daharoni/Miniscope_CMOS_Imaging_Sensor_PCB/v3_2/Assembly Files/CMOSv3_2_BOM.xlsx

Value | Comment | Digikey Part Number | Manufacturer Part Number | Designator | Footprint | LibRef | Quantity
Capacitors
10uF | CAP CER 10UF 16V 20% X5R 0603 | 490-7201-1-ND (http://www.digikey.com/product-detail/en/GRM188R61C106MA73D/490-7201-1-ND/3900482) | GRM188R61C106MA73D (http://www.digikey.com/product-detail/en/GRM188R61C106MA73D/490-7201-1-ND/3900482) | C1 | SMD Capacitor 0603 | Capacitor | 1
22uF | CAP CER 22UF 6.3V 20% X5R 0603 | 490-7611-1-ND (http://www.digikey.com/product-detail/en/GRM188R60J226MEA0D/490-7611-1-ND/4280544) | GRM188R60J226MEA0D (http://www.digikey.com/product-detail/en/GRM188R60J226MEA0D/490-7611-1-ND/4280544) | C2, C17 | SMD Capacitor 0603 | Capacitor | 2
2.2uF | CAP CER 2.2UF 10V X5R 0402 | 490-10451-1-ND | GRM155R61A225KE95D | C3 | SMD CAP 0402 | Capacitor | 1
4.7uF | CAP CER 4.7UF 6.3V X5R 0402 | 490-5915-1-ND | GRM155R60J475ME47D | C4, C9, C12, C20 C27, C29 | SMD CAP 0402 | Capacitor | 6
0.1uF | CAP CER 0.1UF 16V 10% X7R 0402 | 490-3261-1-ND (http://www.digikey.com/product-detail/en/GRM155R71C104KA88D/490-3261-1-ND/702802) | GRM155R71C104KA88D (http://www.digikey.com/product-detail/en/GRM155R71C104KA88D/490-3261-2-ND/675947) | C5, C7, C10, C13, C15, C18, C22, C23, C25, C26, C28, C30, C32 | SMD CAP 0402 | Capacitor | 13
0.01uF | CAP CER 10000PF 50V X7R 0402 | 490-4516-1-ND (http://www.digikey.com/product-detail/en/GRM155R71H103KA88D/490-4516-1-ND/1033275) | GRM155R71H103KA88D (http://www.digikey.com/product-detail/en/GRM155R71H103KA88D/490-4516-1-ND/1033275) | C6, C8, C11, C14, C16, C31 | SMD CAP 0402 | Capacitor | 6
0.047uF | CAP CER 0.047UF 25V 10% X7R 0402 | 490-3254-1-ND (http://www.digikey.com/product-detail/en/GRM155R71E473KA88D/490-3254-1-ND/702795) | GRM155R71E473KA88D (http://www.digikey.com/product-detail/en/GRM155R71E473KA88D/490-3254-1-ND/702795) | C19 | SMD CAP 0402 | Capacitor | 1
4.7uF | CAP CER 4.7UF 16V 10% X5R 0603 | 490-10730-1-ND (http://www.digikey.com/product-detail/en/GRM188R61C475KE11D/490-10730-1-ND/5251370) | GRM188R61C475KE11D (http://www.digikey.com/product-detail/en/GRM188R61C475KE11D/490-10730-1-ND/5251370) | C21 | SMD Capacitor 0603 | Capacitor | 1
1uF | CAP CER 1UF 6.3V X5R 0402 | 490-1320-1-ND (http://www.digikey.com/product-detail/en/GRM155R60J105KE19D/490-1320-1-ND/587919) | GRM155R60J105KE19D (http://www.digikey.com/product-detail/en/GRM155R60J105KE19D/490-1320-1-ND/587919) | C24 | SMD CAP 0402 | Capacitor | 1
Inductors
Ferrite Bead | FIXED IND 2.2UH 600MA 340 MOHM | 490-4994-1-ND (http://www.digikey.com/product-detail/en/LQM21PN2R2MC0D/490-4994-1-ND/1788292) | LQM21PN2R2MC0D (http://www.digikey.com/product-detail/en/LQM21PN2R2MC0D/490-4994-1-ND/1788292) | L1, L2 | LQM21PN2R2MC0D | Ferrite Bead | 2
Ferrite Bead | FERRITE CHIP 600 OHM 1300MA 0603 | 490-5258-1-ND (http://www.digikey.com/product-detail/en/BLM18KG601SN1D/490-5258-1-ND/1982781) | BLM18KG601SN1D (http://www.digikey.com/product-detail/en/BLM18KG601SN1D/490-5258-1-ND/1982781) | L3, L4, L5 | BLM18KG601SN1D | Ferrite Bead | 3
Ferrite Bead | FIXED IND 4.7UH 750MA 260 MOHM | 1276-6204-1-ND (http://www.digikey.com/product-detail/en/CIG21L4R7MNE/1276-6204-1-ND/3972122) | CIG21L4R7MNE (http://www.digikey.com/product-detail/en/CIG21L4R7MNE/1276-6204-1-ND/3972122) | L6 | CIG21L4R7MNE | Ferrite Bead | 1
Ferrite Bead | FIXED IND 100UH 340MA 1.82 OHM | 587-1628-1-ND (http://www.digikey.com/product-detail/en/CBC3225T101MR/587-1628-1-ND/1008243) | CBC3225T101MR (http://www.digikey.com/product-detail/en/CBC3225T101MR/587-1628-1-ND/1008243) | L7 | CBC3225T101MR | Ferrite Bead | 1
Resistors
500 | RES SMD 499 OHM 1% 1/16W 0402 | 311-499LRCT-ND (http://www.digikey.com/product-detail/en/RC0402FR-07499RL/311-499LRCT-ND/729570) | RC0402FR-07499RL | R1 | SMD RES 0402 | Resistor | 1
100k | RES SMD 100K OHM 1% 1/16W 0402 | 311-100KLRCT-ND (http://www.digikey.com/product-detail/en/RC0402FR-07100KL/311-100KLRCT-ND/729473) | RC0402FR-07100KL (http://www.digikey.com/product-detail/en/RC0402FR-07100KL/311-100KLRCT-ND/729473) | R2, R6 | SMD RES 0402 | Resistor | 2
49.9 | RES SMD 49.9 OHM 1% 1/16W 0402 | 311-49.9LRCT-ND (http://www.digikey.com/product-detail/en/RC0402FR-0749R9L/311-49.9LRCT-ND/729568) | RC0402FR-0749R9L (http://www.digikey.com/product-detail/en/RC0402FR-0749R9L/311-49.9LRCT-ND/729568) | R3 | SMD RES 0402 | Resistor | 1
10k | RES SMD 10K OHM 1% 1/16W 0402 | 311-10.0KLRCT-ND (http://www.digikey.com/product-detail/en/RC0402FR-0710KL/311-10.0KLRCT-ND/729470) | RC0402FR-0710KL (http://www.digikey.com/product-detail/en/RC0402FR-0710KL/311-10.0KLRCT-ND/729470) | R4, R5, R14 | SMD RES 0402 | Resistor | 3
3.3k | RES SMD 3.3K OHM 1% 1/16W 0402 | 311-3.30KLRCT-ND (http://www.digikey.com/product-detail/en/RC0402FR-073K3L/311-3.30KLRCT-ND/729527) | RC0402FR-073K3L (http://www.digikey.com/product-detail/en/RC0402FR-073K3L/311-3.30KLRCT-ND/729527) | R7, R8 | SMD RES 0402 | Resistor | 2
1k | RES SMD 1K OHM 1% 1/16W 0402 | 311-1.00KLRCT-ND (http://www.digikey.com/product-detail/en/RC0402FR-071KL/311-1.00KLRCT-ND/729460) | RC0402FR-071KL (http://www.digikey.com/product-detail/en/RC0402FR-071KL/311-1.00KLRCT-ND/729460) | R9, R10, R11 | SMD RES 0402 | Resistor | 3
10 | RES SMD 10 OHM 1% 1/10W 0402 | p10.0lct-nd | erj-2rkf10r0x | R12 | SMD RES 0402 | Resistor | 1
1.25k | RES SMD 1.24K OHM 1% 1/16W 0402 | 311-1.24KLRCT-ND (http://www.digikey.com/product-detail/en/RC0402FR-071K24L/311-1.24KLRCT-ND/2827932) | RC0402FR-071K24L (http://www.digikey.com/product-detail/en/RC0402FR-071K24L/311-1.24KLRCT-ND/2827932) | R13 | SMD RES 0402 | Resistor | 1
ICs
OSC_26MHz_EPSON | OSC XO 26.000MHZ CMOS SMD | SER3701CT-ND (http://www.digikey.com/product-detail/en/SG-211SCE%2026.0000MT3/SER3701CT-ND/2403474) | SG-211SCE 26.0000MT3 | u6 | OSC SG_211SCE 26MHz | OSC_26MHz_EPSON | 1
TPS62172DSGT | IC REG BUCK 3.3V 0.5A SYNC 8WSON | 296-29879-1-ND (http://www.digikey.com/product-detail/en/TPS62172DSGT/296-29879-1-ND/2781002) | TPS62172DSGT (http://www.digikey.com/product-detail/en/TPS62172DSGT/296-29879-1-ND/2781002) | U1 | DSG8-1600X900TP | TPS62172DSGT | 1
TPS62231DRYT | IC REG BUCK 1.8V 0.5A SYNC 6SON | 296-24485-1-ND (http://www.digikey.com/product-detail/en/TPS62231DRYT/296-24485-1-ND/2057751) | TPS62231DRYT (http://www.digikey.com/product-detail/en/TPS62231DRYT/296-24485-1-ND/2057751) | U2 | DRY6 | TPS62231DRYT | 1
DS90UB913A | IC SER/DES 10-100MHZ FPD 32WQFN | 296-37226-1-ND (http://www.digikey.com/scripts/DkSearch/dksus.dll?Detail&itemSeq=181269562&uq=635797476610395265) | DS90UB913ATRTVTQ1 | U3 | WQFN32 for DS90UB913A | DS90UR913A | 1
LT3092EDD#PBF | IC CURRENT SOURCE 1% 8DFN | LT3092EDD#PBF-ND | LT3092EDD#PBF | U4 | LT-DD-8_V | LT3092EDD#PBF | 1
DAC5571IDBVR | 8 BIT 12C SNGL CHNL DAC SOT23-6 | 296-38918-1-ND (http://www.digikey.com/product-detail/en/DAC5571IDBVR/296-38918-1-ND/5143024) | DAC5571IDBVR (http://www.digikey.com/product-detail/en/DAC5571IDBVR/296-38918-1-ND/5143024) | U5 | TI-DBV6_M | DAC5571IDBVR | 1
LED 0603 | LED RED CLEAR 0603 SMD | 160-1447-1-ND | LTST-C191KRKT | D1 | LED_0603 | LED 0603 | 1
MT9V032C12STM | 1/3-Inch Wide-VGA CMOS Digital Image Sensor |  | MT9V032C12STM | S1 | LCC, 48-Pins | CMOS Sensor | 1
