daharoni/Miniscope_CMOS_Imaging_Sensor_PCB/v3_2/Assembly Files/sensor-pcb-components.png

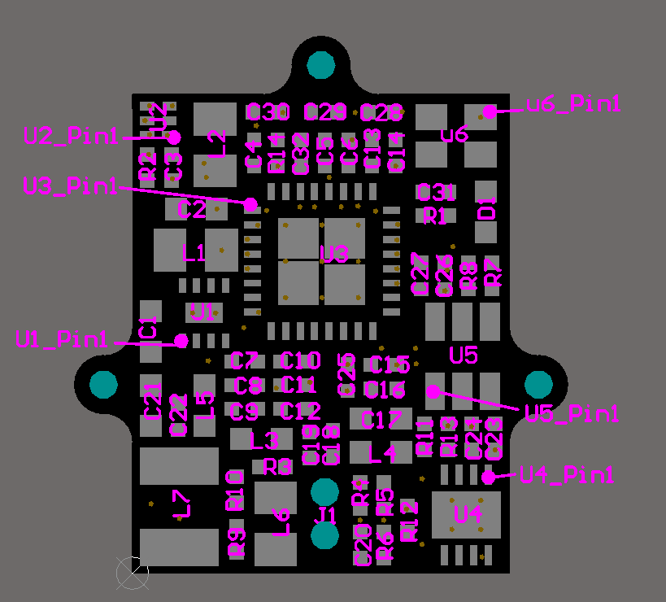
v3_2/Assembly Files/sensor-pcb-components.png
