daharoni/Miniscope_CMOS_Imaging_Sensor_PCB/v3_2/Assembly Files/CMOSv3_2_PCB_Assy_Info.docx

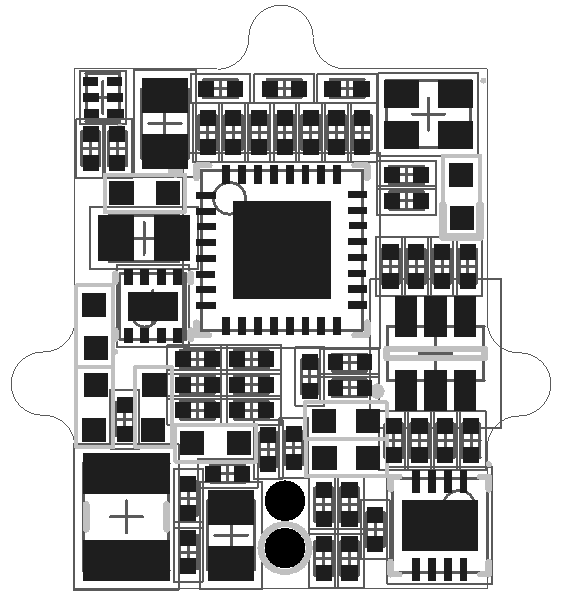
[picture p2: figure]

CMOS Imaging Sensor Circuit Board Assembly Information

- Top layer component descriptors: Mechanical layer 5
- Bottom layer component descriptors: Mechanical layer 6
- Double sided assembly: Yes
- Pin 1 identifiers on Mechanical Layers 5 (GM5) and 6 (GM6)
  - Top: GM5
  - Bottom: GM6

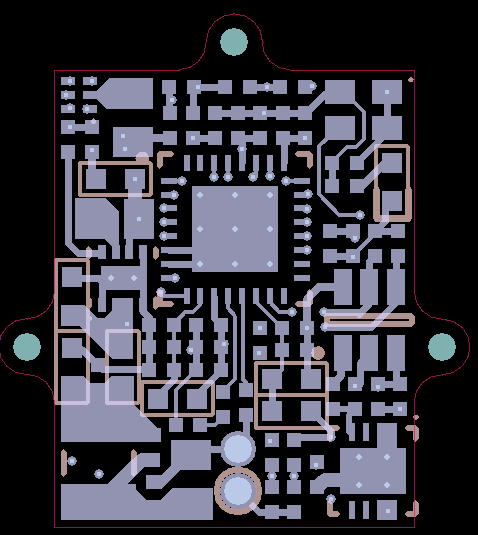
[picture p3: figure]

- D1 (LED) orientation shown below

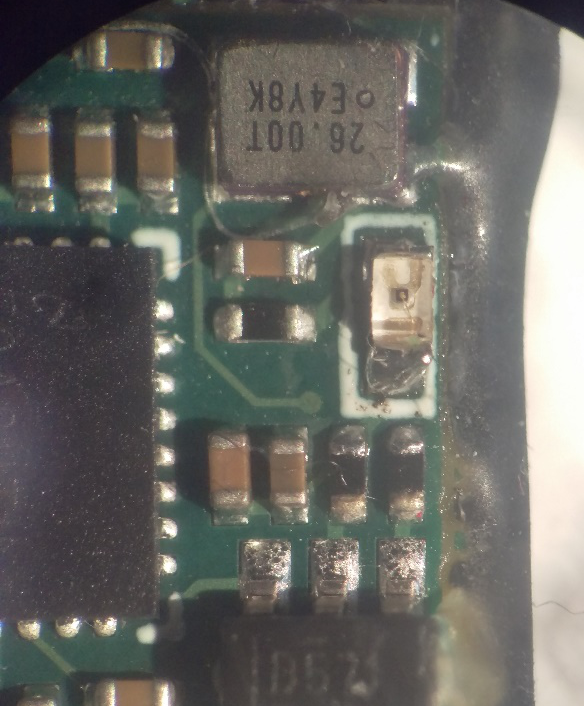
[picture p4: figure]
