daharoni/Miniscope_CMOS_Imaging_Sensor_PCB/v3_0/Assembly Files/CMOS_Imaging_Sensor_PCB_Assy_Info.docx

CMOS Imaging Sensor Circuit Board Assembly Information

- Top layer component descriptors: Mechanical layer 5
- Bottom layer component descriptors: Mechanical layer 6
- Double sided assembly: Yes

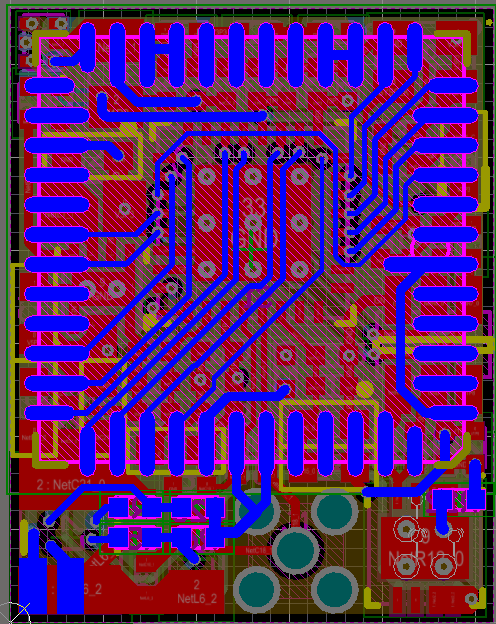
[picture p14: figure]
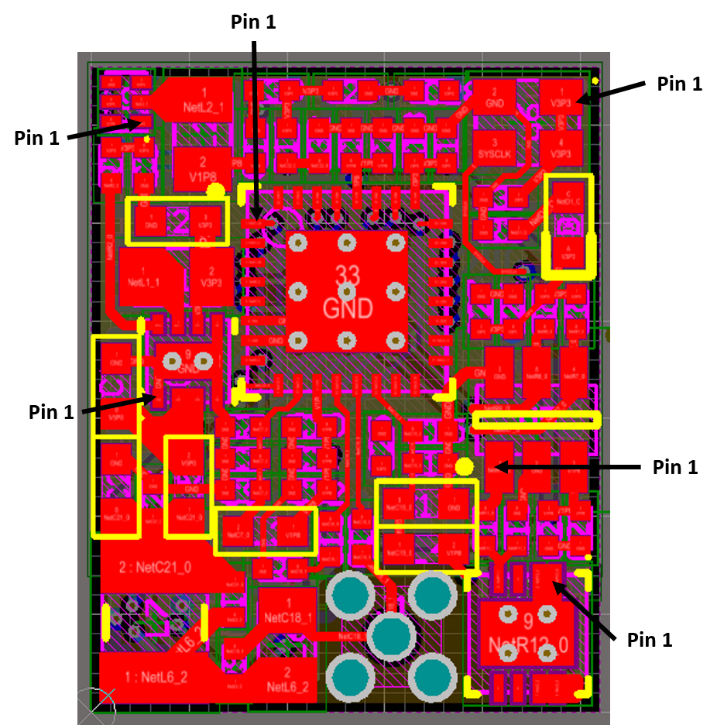
[picture p15: figure]

- Pin 1 identifiers shown below

Pin 1 of S1

- D1 (LED) orientation shown below

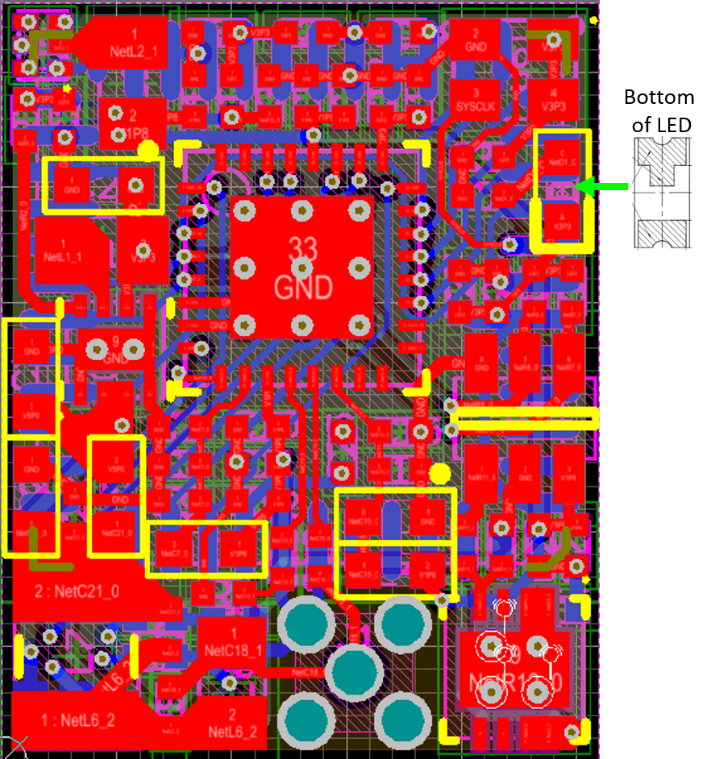
[picture p16: figure]
