daharoni/Miniscope_CMOS_Imaging_Sensor_PCB/(threads)

Thread 1 (2016-04-26):

Put PDFs of schematics and board layouts somewhere in repo

jonnew, 2016-04-26:
Its very hard for the majority of people to manipulate Altium files because they are an extremely closed company -- even the viewer requires account access etc. Altium has great capabilities for outputting schematics and images of board layout as PDFs. I suggest that these be added to repos that have PCB design docs like these.

Gerbers are a good start, but some people won't even know what those are or how to view them. Standard PDFs, preferably right at the top of the file PCB file structure would be great.

jonnew, 2016-04-26:
And, I'm crazy! Its in the top to of the file structure just like I wanted....

Closed 2016-04-26.

Thread 2 (2016-10-28):

Board thickness specification

jonnew, 2016-10-28:
Does the image sensor PCB have to be a particular thickness? I could not find this spec on the .docx file with assembly info.

daharoni, 2016-10-28:
The recommended thickness is in the fabrication CMOSv3_2_PCB_Fab_Info.docx and is 0.031" (half the thickness of standard PCBs). There is no strict requirement on the thickness of this PCB but the thinner the PCB the lighter the entire system will be. I think 0.031" is a good balance between weight, rigidness, and ease of finding a fabrication house that can make it.

jonnew, 2016-10-28:
Great! 0.8mm it is.

Closed 2016-10-28.
