daharoni/Miniscope_CMOS_Imaging_Sensor_PCB/v3_0/CMOS_Imaging_Sensor_PCB_Schematics_Layout.PDF

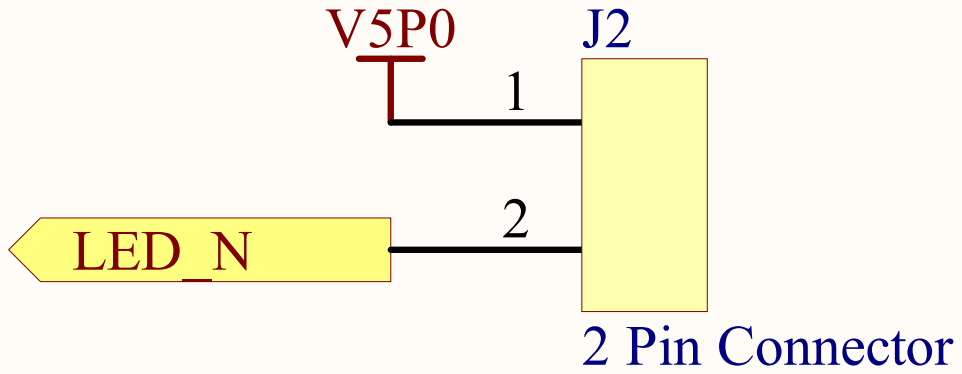
[picture p25: page 1]

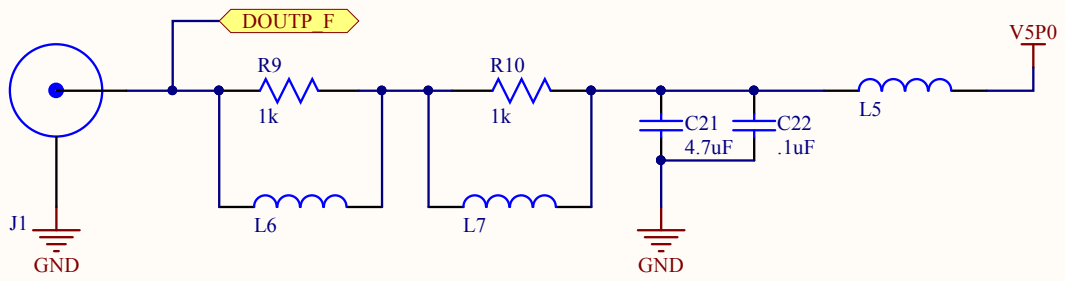
[picture p26: page 2]

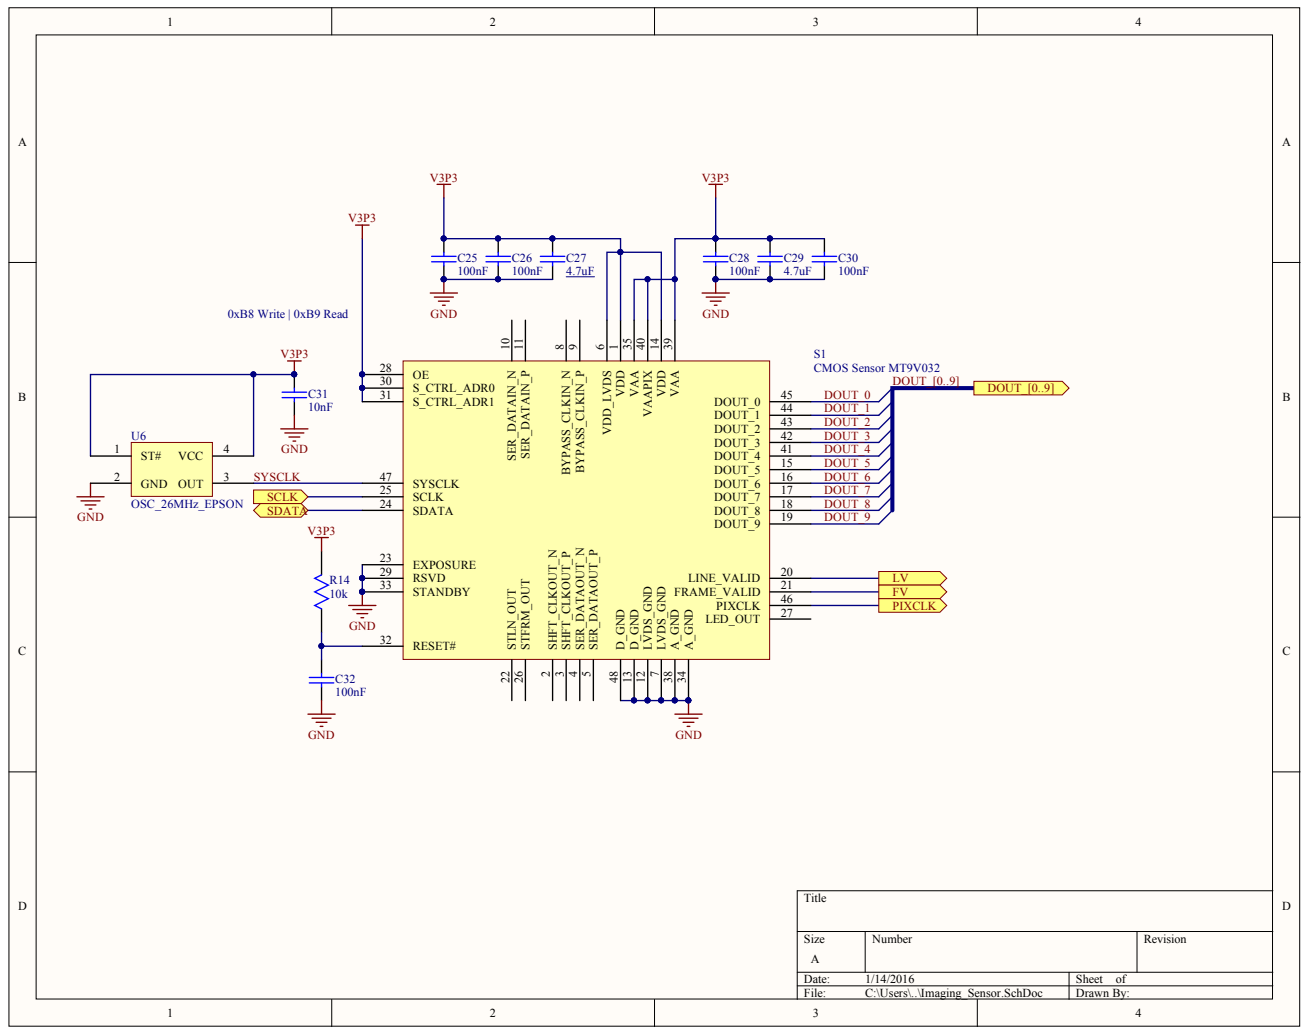
[picture p27: page 3]

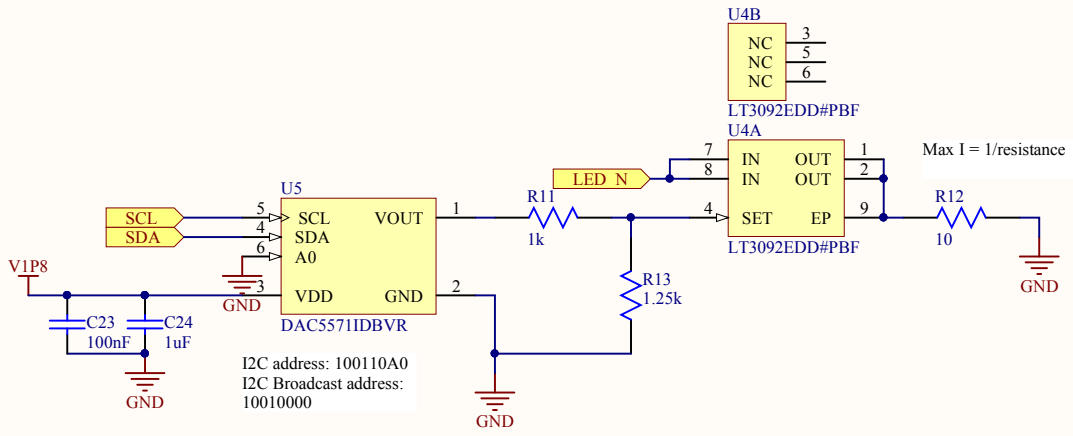
[picture p28: page 4]

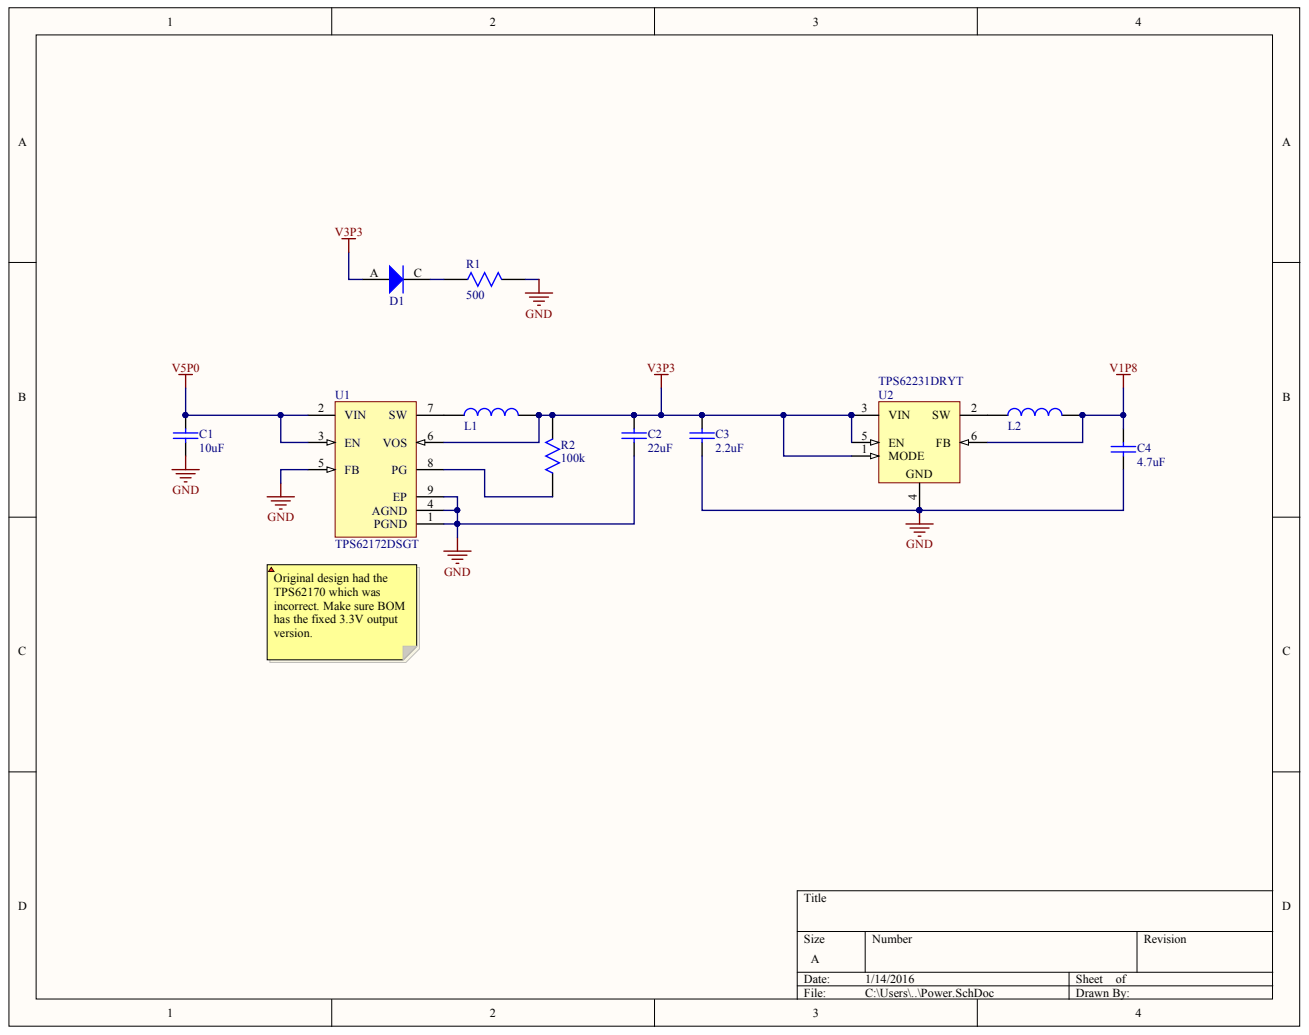
[picture p29: page 5]

Original design had the
TPS62170 which was
incorrect. Make sure BOM
has the fixed 3.3V output
version.

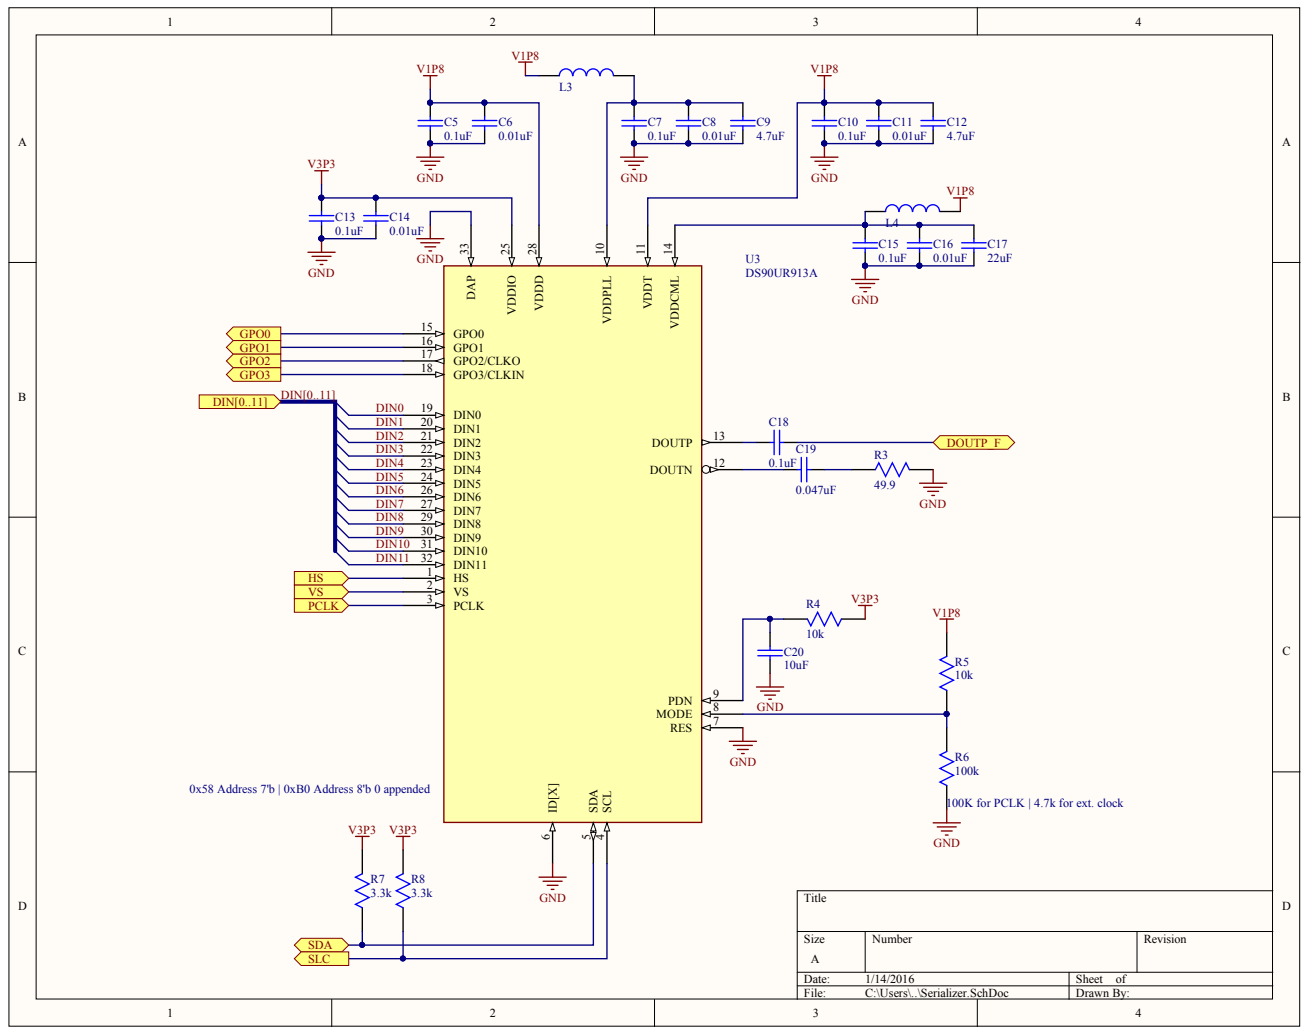
[picture p30: page 6]

C13 C14
0.1uF

100K for PCLK | 4.7k for ext. clock

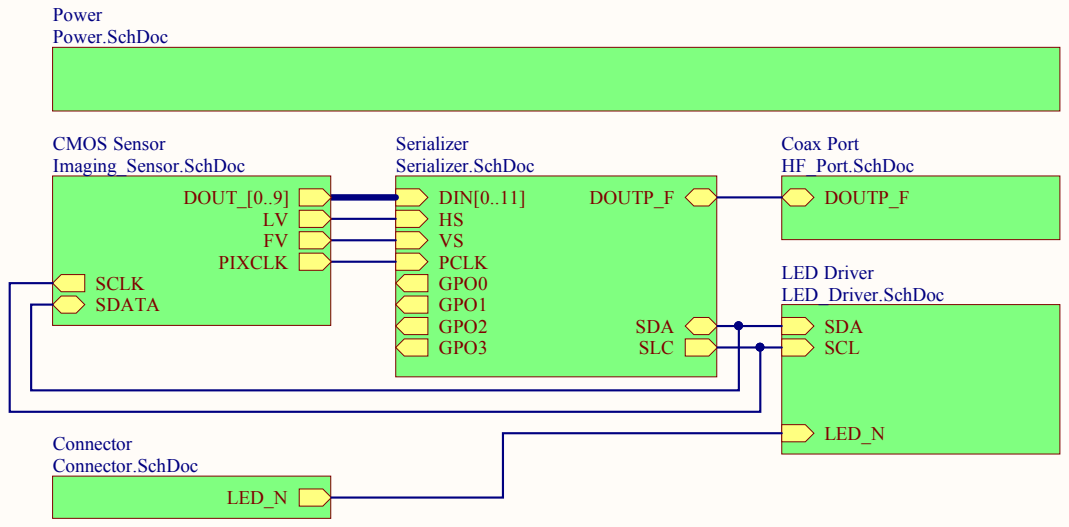
[picture p31: page 7]

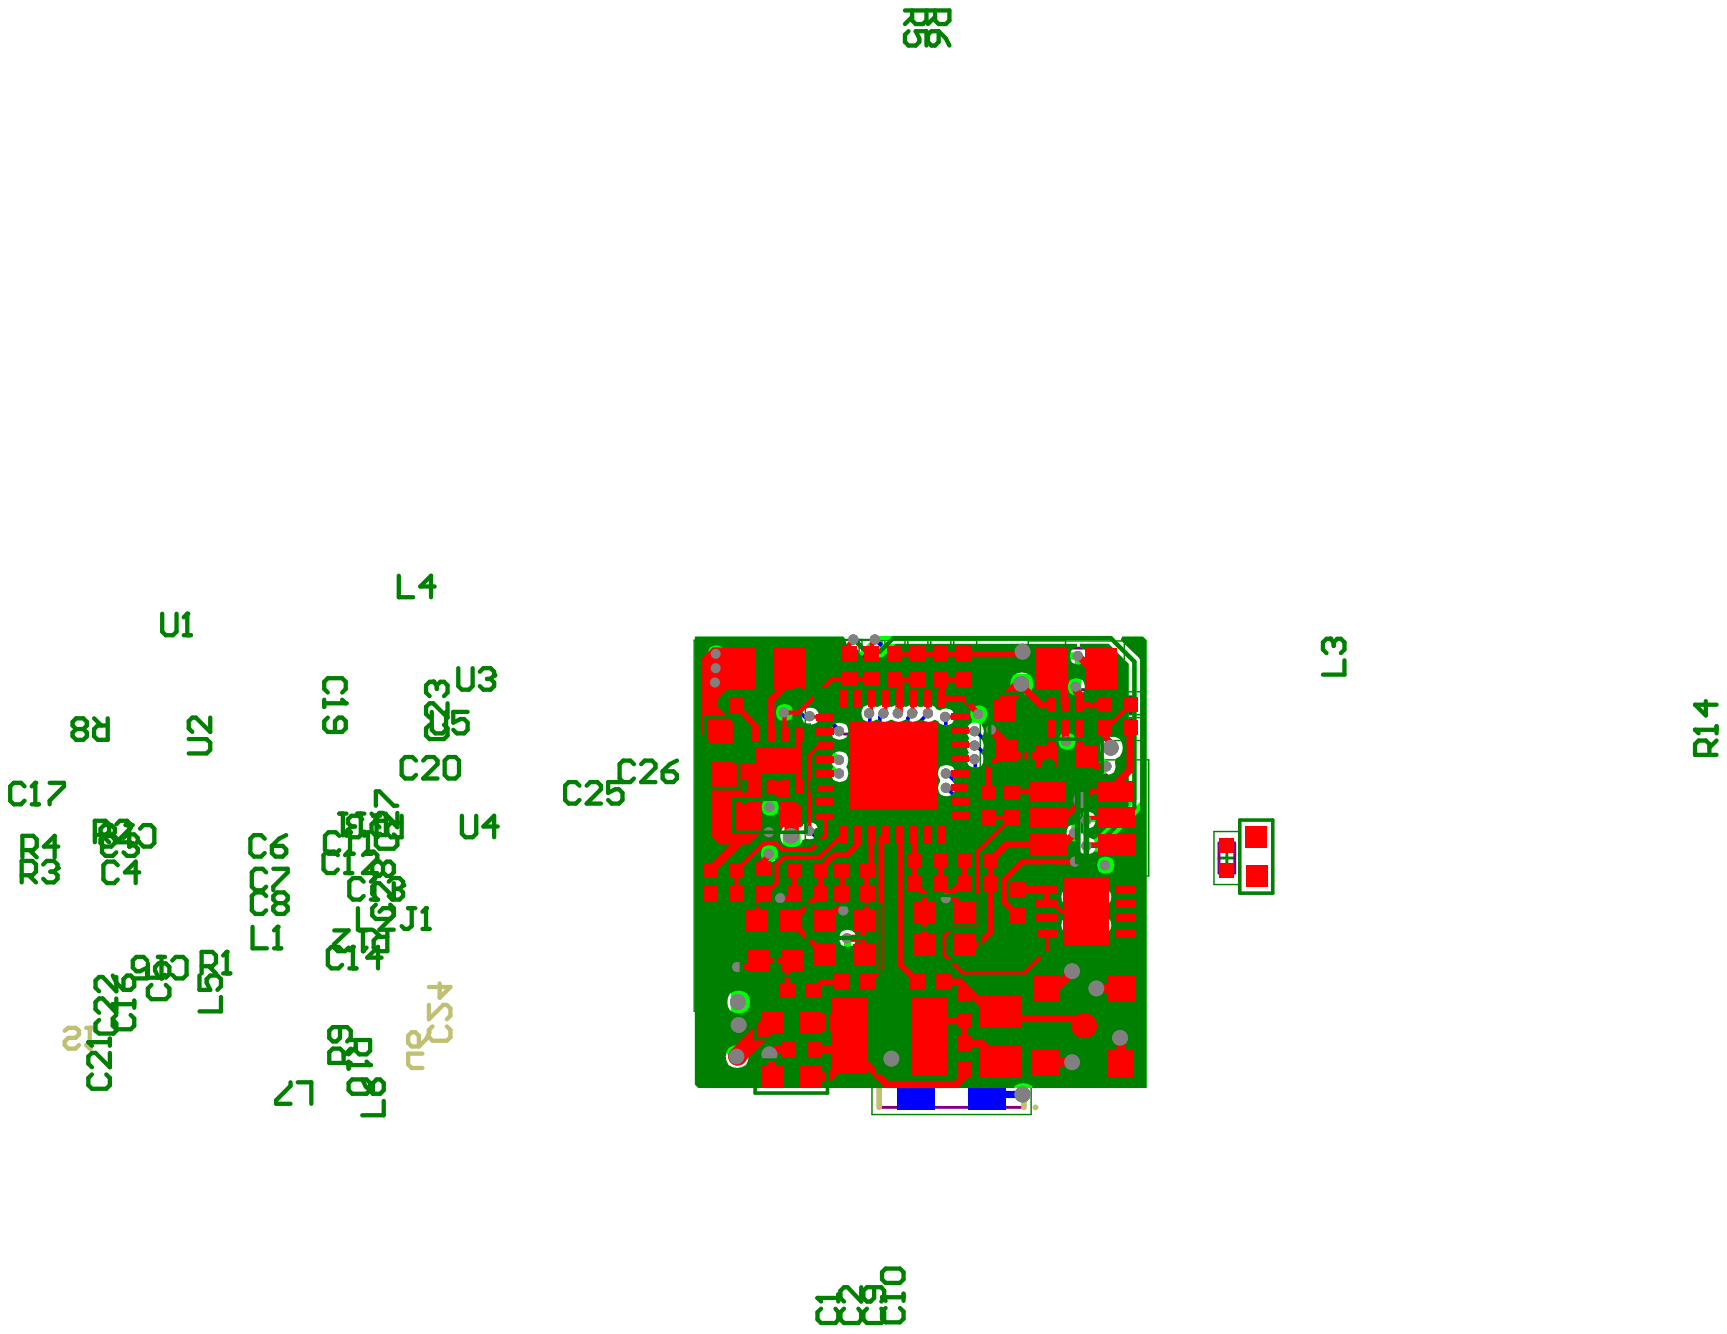
[picture p32: page 8]

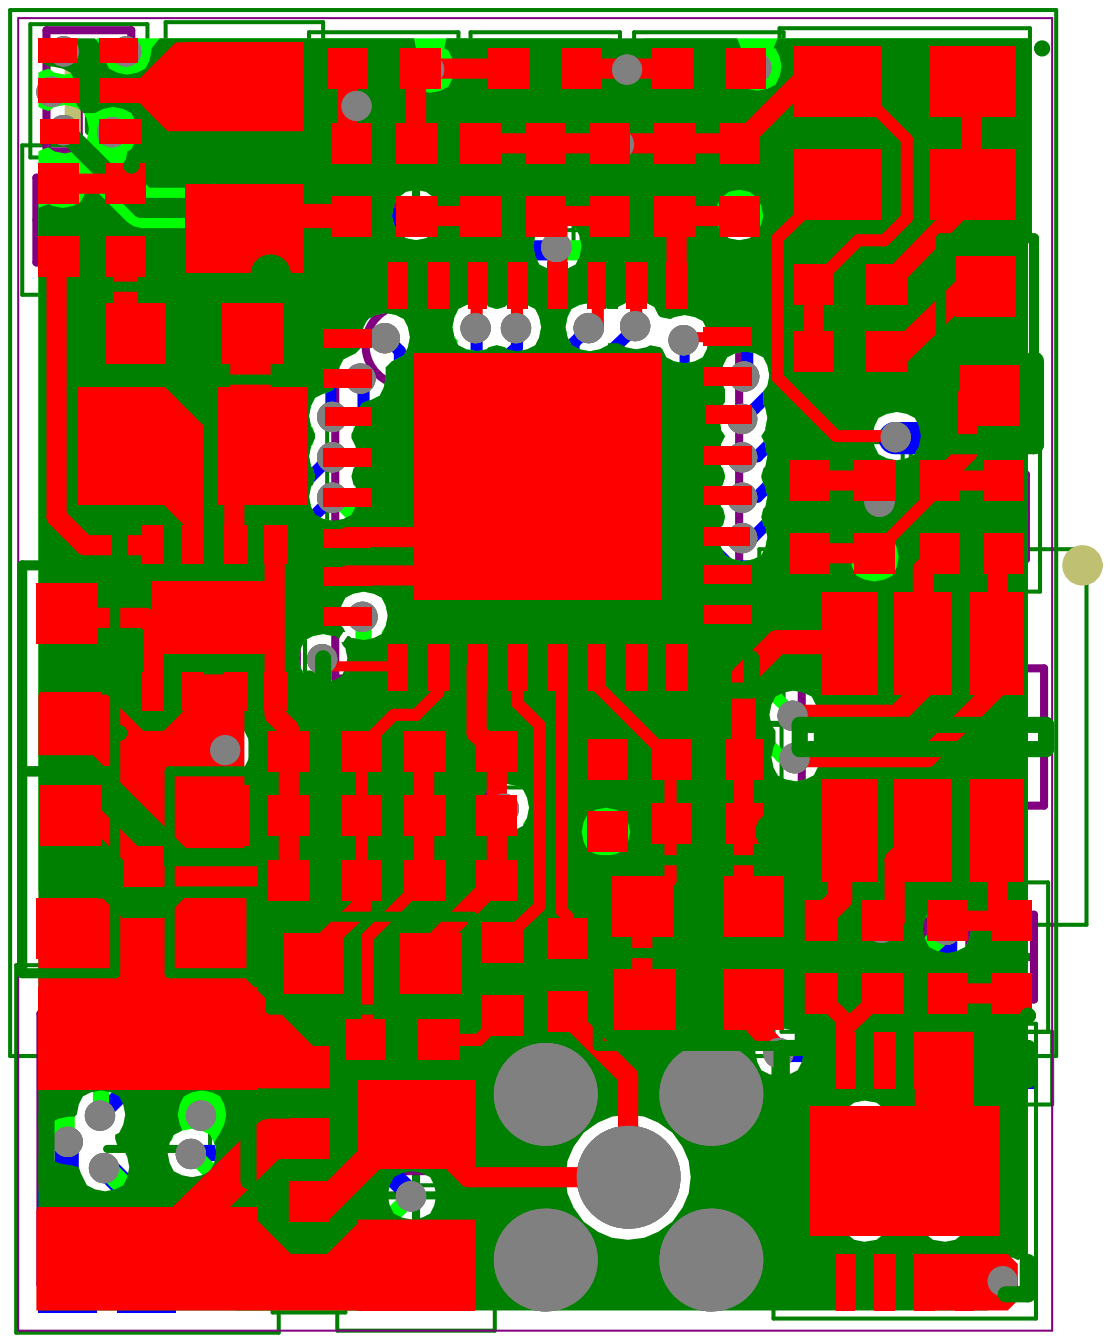
[picture p33: page 9]
