daharoni/Miniscope_CMOS_Imaging_Sensor_PCB/(list of files, drawings)

Other design files:
v3_0/Design Files/Connector.SchDoc
v3_0/Design Files/HF_Port.SchDoc
v3_0/Design Files/Imaging_Sensor.SchDoc
v3_0/Design Files/LED_Driver.SchDoc
v3_0/Design Files/Power.SchDoc
v3_0/Design Files/Serializer4Sensor.PrjPcb
v3_0/Design Files/Serializer.SchDoc
v3_0/Design Files/Serializer_System2.PcbDoc
v3_0/Design Files/Serializer_System.SchDoc
v3_2/Design Files/Connector.SchDoc
v3_2/Design Files/HF_Port.SchDoc
v3_2/Design Files/Imaging_Sensor.SchDoc
v3_2/Design Files/LED_Driver.SchDoc
v3_2/Design Files/Power.SchDoc
v3_2/Design Files/Serializer.SchDoc
v3_2/Design Files/Serializer_System2.PcbDoc
v3_2/Design Files/Serializer_System.SchDoc
