daharoni/Miniscope_CMOS_Imaging_Sensor_PCB/(commit log)

2016-01-08 Initial Upload
    [Connector.SchDoc, HF_Port.SchDoc, Imaging_Sensor.SchDoc, LED_Driver.SchDoc, Power.SchDoc, Serializer.SchDoc, Serializer4Sensor.PrjPcb, Serializer_System.SchDoc]
2016-01-15 PDF of PCB Project
2016-01-20 Updated LED Orientation Figure
2016-01-27 Corrected to newest version
    [Serializer_System2.GBL, Serializer_System2.GBO, Serializer_System2.GM1, Serializer_System2.GTL, Serializer_System2.GTO, Serializer_System2.GTP, Serializer_System2.GTS]
2016-04-13 New version
    [CMOSv3_2.GBL, CMOSv3_2.GBO, CMOSv3_2.GBP, CMOSv3_2.GBS, CMOSv3_2.GM1, CMOSv3_2.GTL, CMOSv3_2.GTO, CMOSv3_2.GTP]
2017-01-31 Schematic labeling component locations for assembly of PCB
